serolugo/logic-lab/docs/pinout.md

# Pinout Information

Pinout reference files and Quartus constraint files will be added in future updates.

Planned additions:

- GPIO mapping
- Seven-segment display pins
- LED assignments
- Switch assignments
- PMOD connector mapping
- Example Quartus constraint files
