serolugo/logic-lab/docs/toolchain.md

# Toolchain

## FPGA Design Software

The Logic Lab boards were designed for use with Intel Quartus Prime Lite.

Supported FPGA families:

- Intel MAX V
- Intel MAX 10

## PCB Design

Hardware was designed using EasyEDA Pro.

## Manufacturing

Boards were manufactured using JLCPCB.
