serolugo/logic-lab/boards/logic-lab-max-v/Images/20260401_134947.jpg

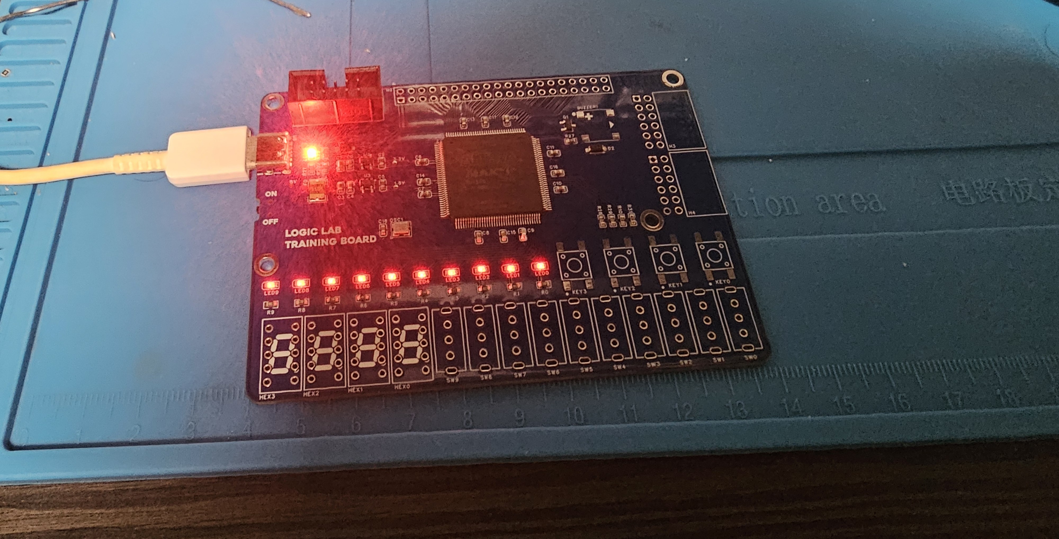
boards/logic-lab-max-v/Images/20260401_134947.jpg
