serolugo/logic-lab/boards/logic-lab-max-10/Schematic/logic-lab-max-10-schematic.pdf

# USB C EH

# POWER SWITCH

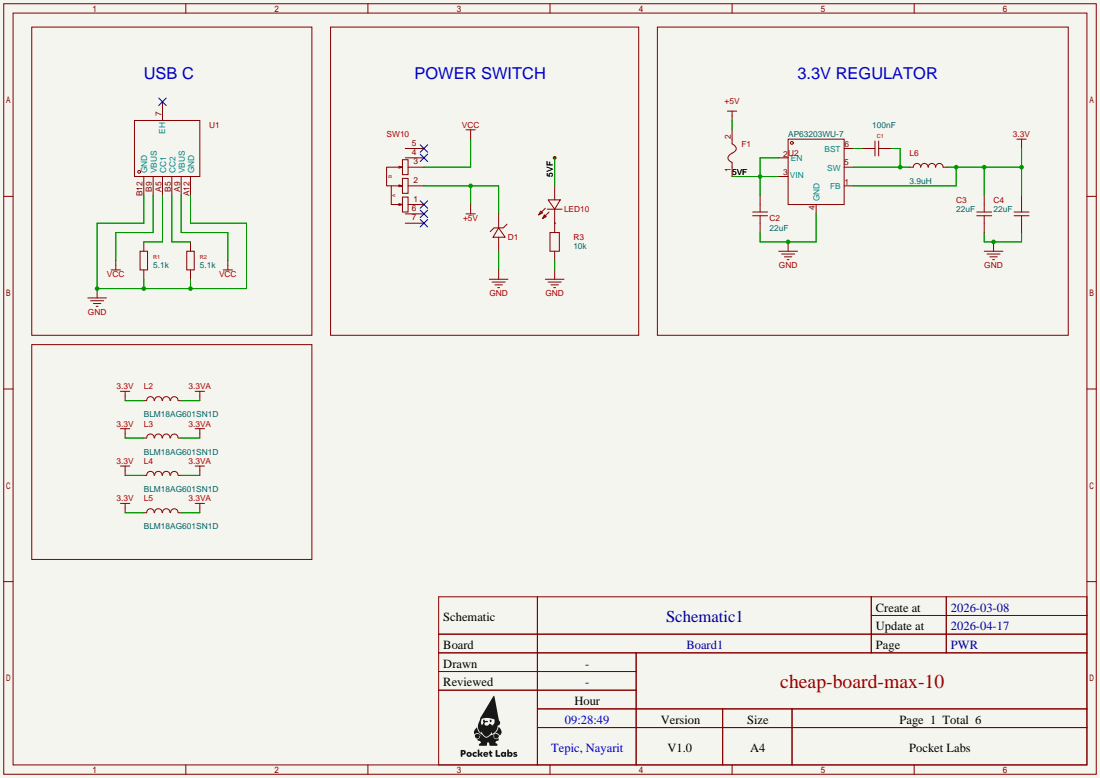
[picture p8: page 1]

Schematic | Schematic1 | Create at | 2026-03-08

Update at | 2026-04-17

Board | Board1 | Page | PWR
Drawn | - | cheap-board-max-10
Reviewed | -

Hour
09:28:49 | Version | Size | Page 1 Total 6

Tepic, Nayarit | V1.0 | A4 | Pocket Labs

# MAX 10 FPGA

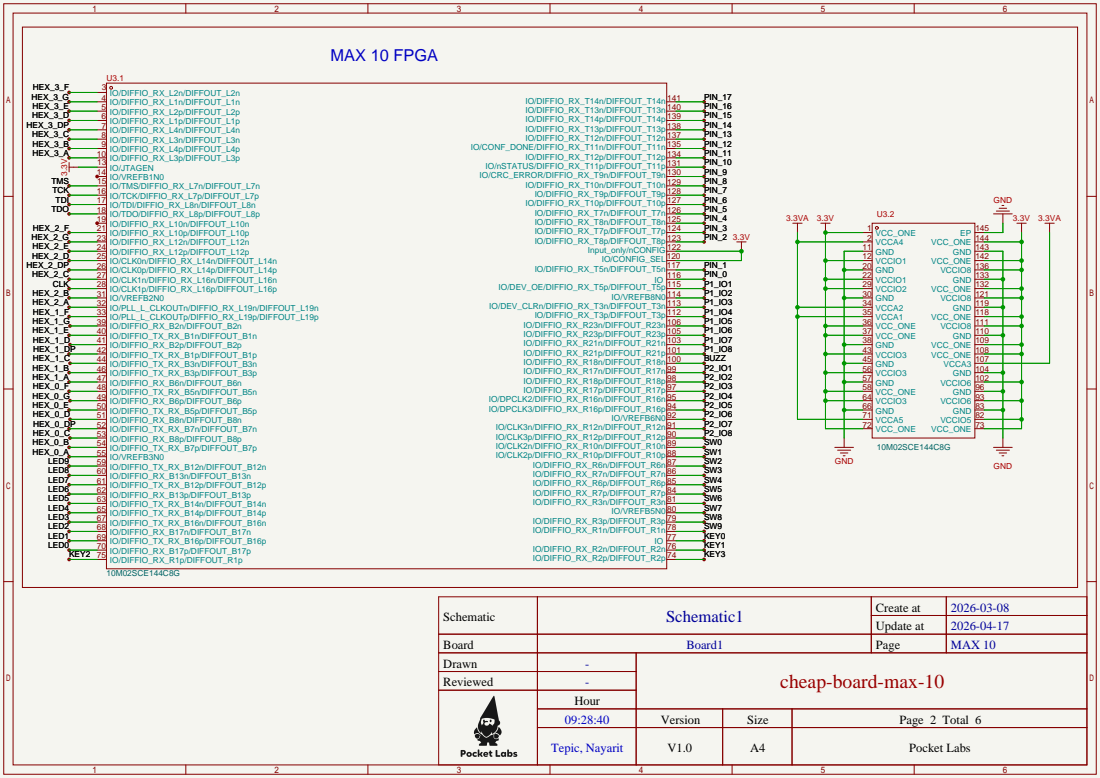
[picture p9: page 2]

Schematic | Schematic1 | Create at | 2026-03-08

Update at | 2026-04-17

Board | Board1 | Page | MAX 10
Drawn | - | cheap-board-max-10
Reviewed | -

Hour
09:28:40 | Version | Size | Page 2 Total 6

# DECOUPLING

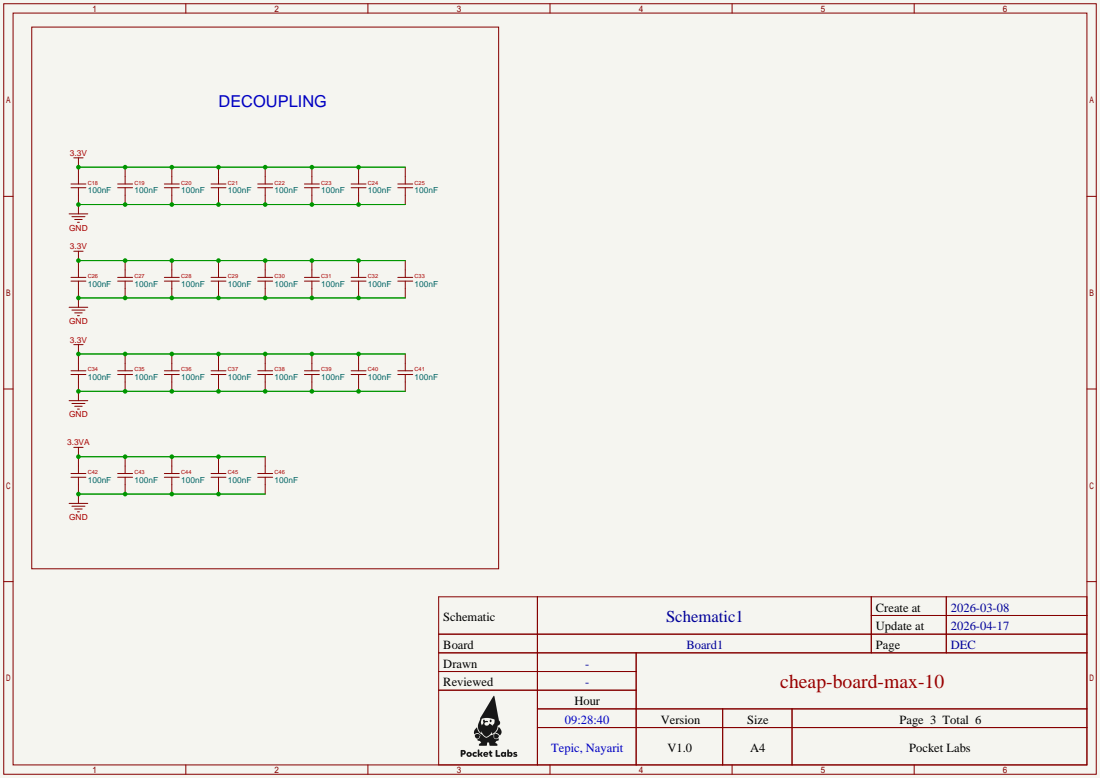
[picture p10: page 3]

Schematic | Schematic1 | Create at | 2026-03-08

Update at | 2026-04-17

Board | Board1 | Page | DEC
Drawn | - | cheap-board-max-10
Reviewed | -

Hour
09:28:40 | Version | Size | Page 3 Total 6

# SWITCH

# BUTTONs

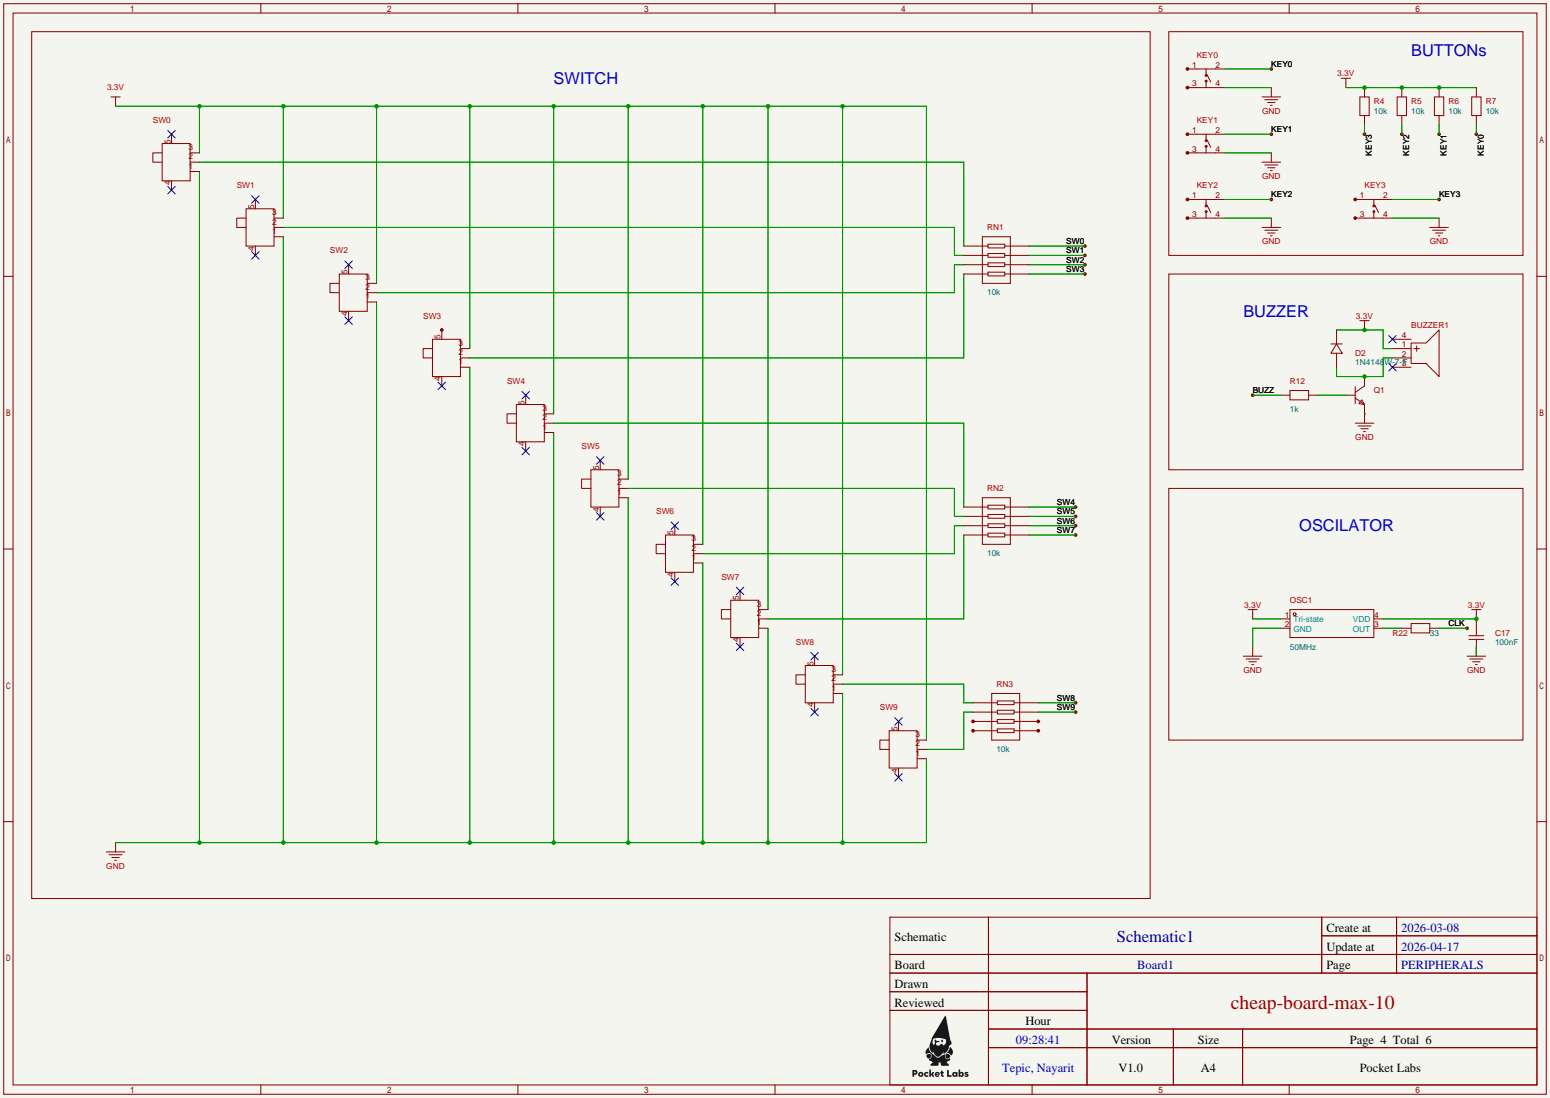
[picture p11: page 4]

Schematic | Schematic1 | Create at | 2026-03-08

Update at | 2026-04-17

Board | Board1 | Page | PERIPHERALS
Drawn | | cheap-board-max-10
Reviewed

Hour
09:28:41 | Version | Size | Page 4 Total 6

# 7 SEG DISPLAY

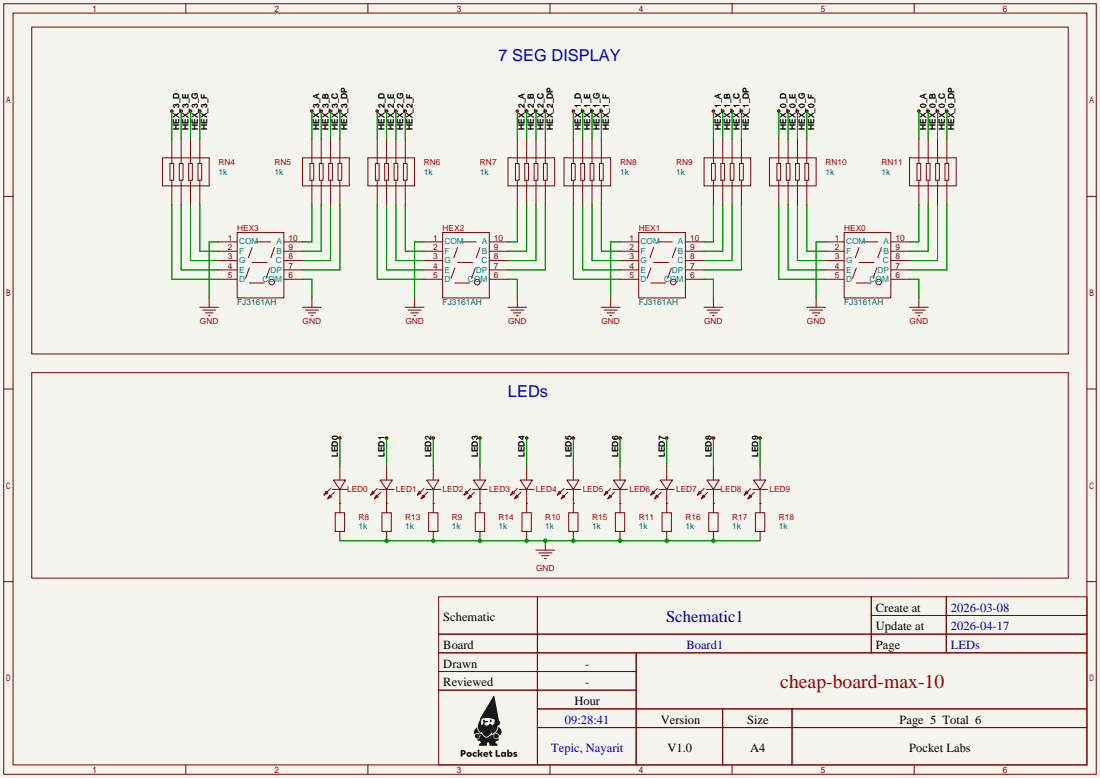
[picture p12: page 5]

Schematic | Schematic1 | Create at | 2026-03-08

Update at | 2026-04-17

Board | Board1 | Page | LEDs
Drawn | - | cheap-board-max-10
Reviewed | -

Hour
09:28:41 | Version | Size | Page 5 Total 6

40 40 39 39 | 38 38 37 37 | 36 36 35 35 | 34 34 33 33 | 32 32 31 31 | 30 30 29 29 | 28 28 27 27 | 26 26 25 25 | 24 24 23 23 | 22 22 21 21 | 20 20 19 19 | 18 18 17 17 | 16 16 15 15 | 14 14 13 13 | 12 12 11 11 | 10 10 9

# JTAG

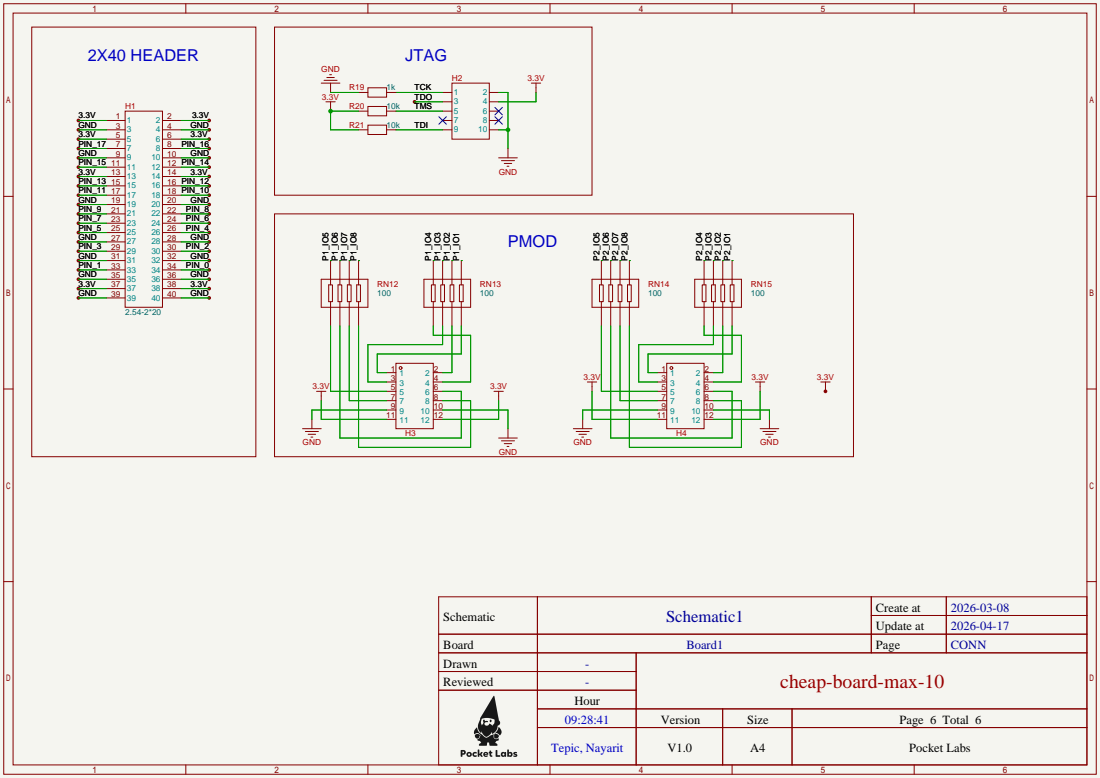
[picture p13: page 6]

Schematic | Schematic1 | Create at | 2026-03-08

Update at | 2026-04-17

Board | Board1 | Page | CONN
Drawn | - | cheap-board-max-10
Reviewed | -

Hour
09:28:41 | Version | Size | Page 6 Total 6
