serolugo/logic-lab/boards/logic-lab-max-v/Schematic/logic-lab-max-v-schematic.pdf

# USB C EH MAX V CPLD

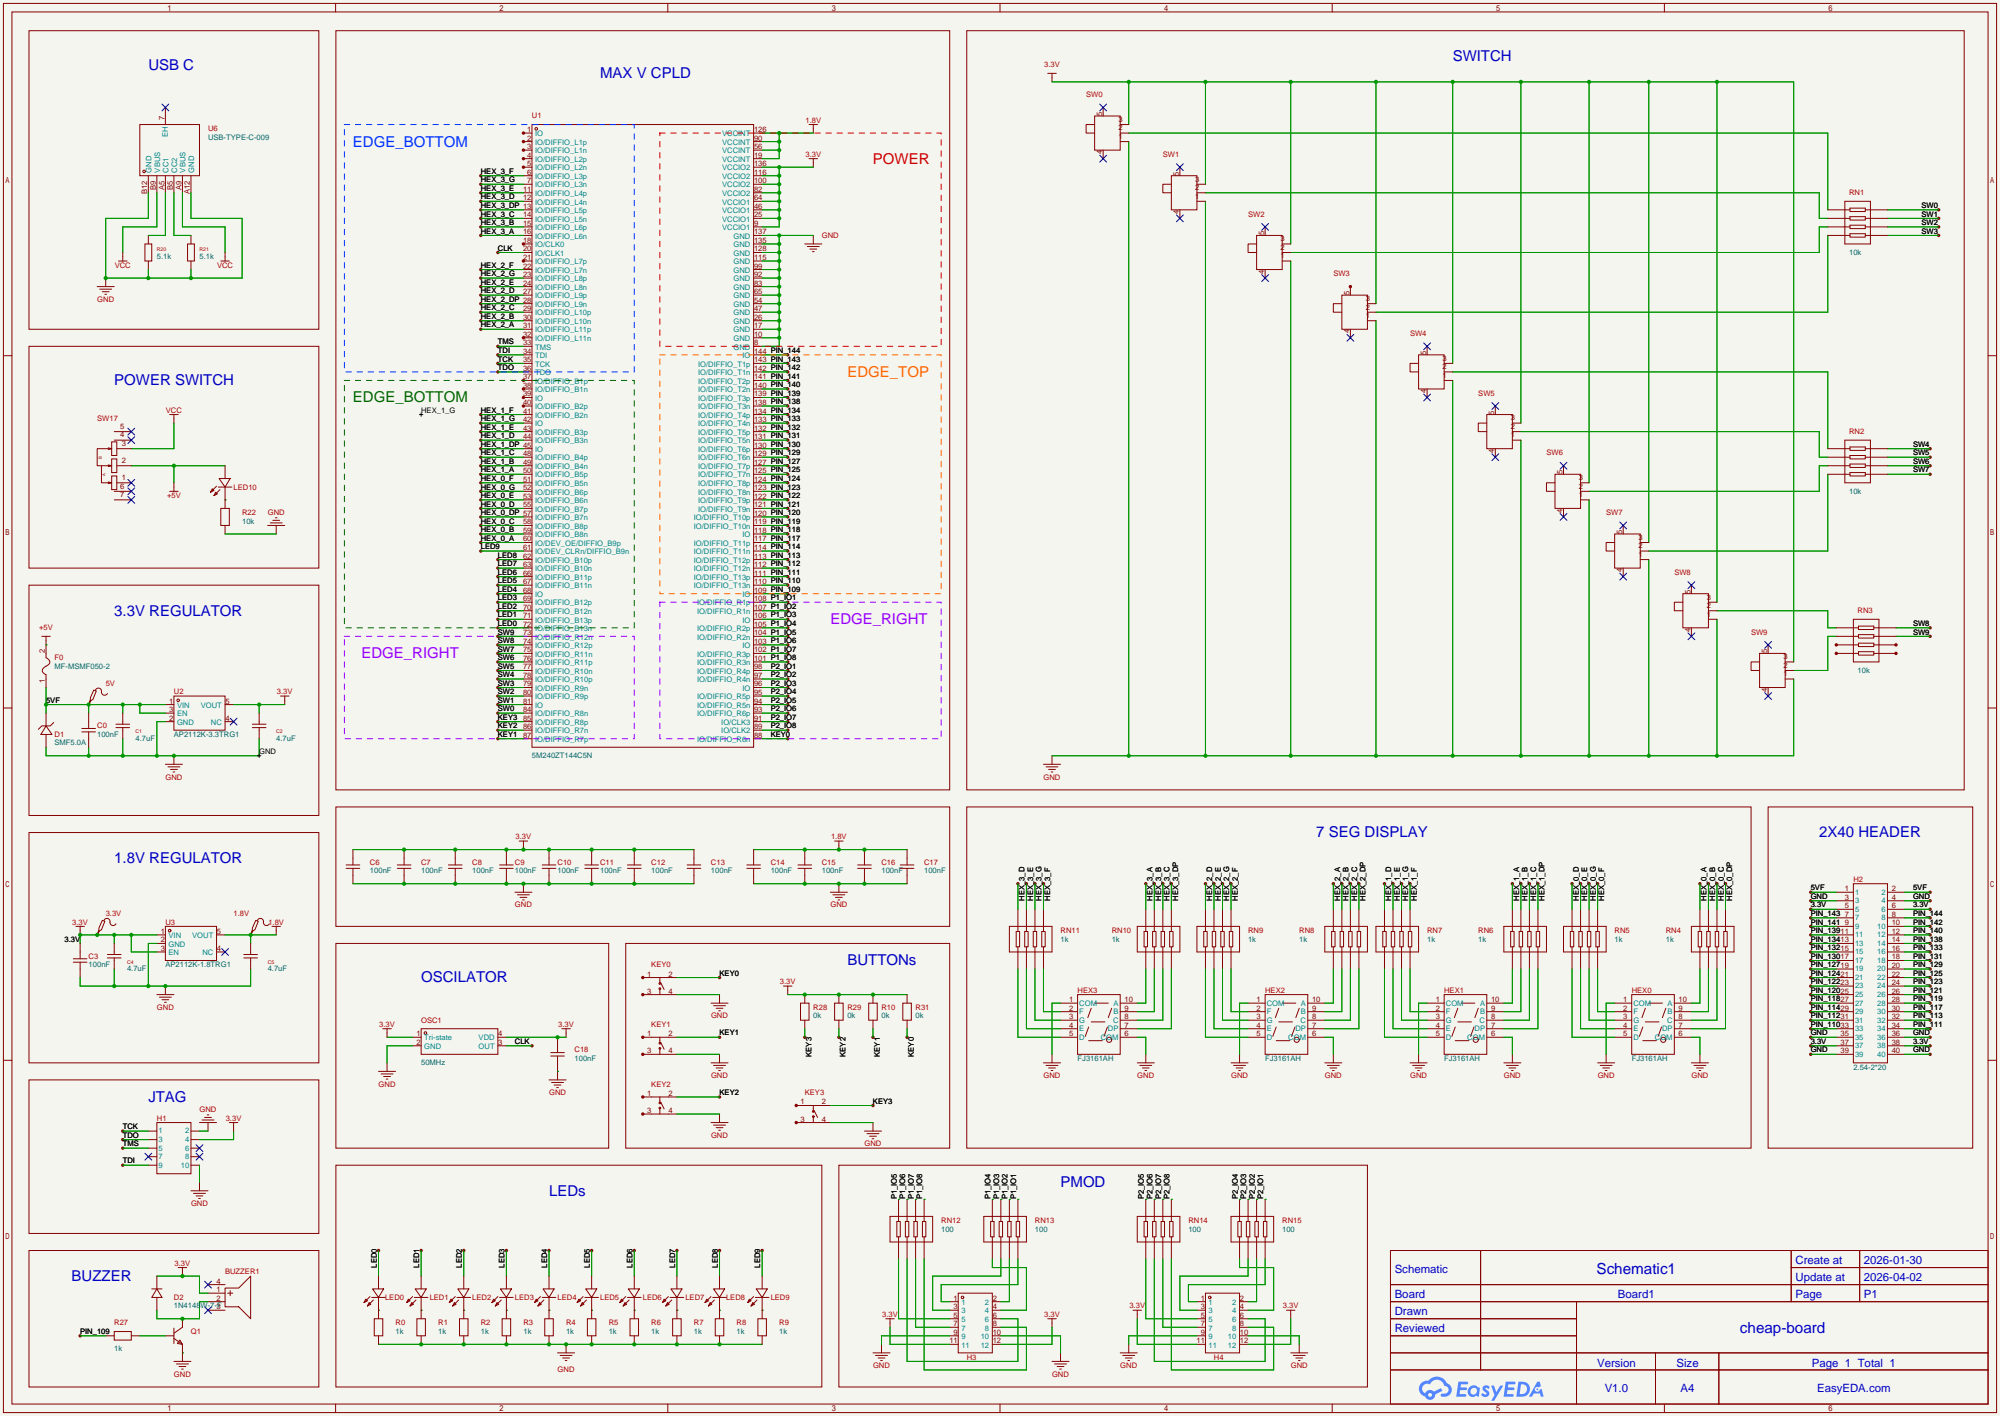
[picture p14: page 1]

VCCIO1 25 VCCIO1 46 VCCIO1 64 VCCIO2 82 VCCIO2 100 VCCIO2 116 VCCIO2 136 VCCINT 19 VCCINT 56 VCCINT 90 VCCINT 126

GND 10 GND 17 GND 26 GND 47 GND 54 GND 65 GND 83 GND 92 GND 99 GND 115 GND 128 GND 135 GND 137 VCCIO1 9

Schematic | Schematic1 | Create at | 2026-01-30

Update at | 2026-04-02

Version | Size | Page 1 Total 1
V1.0 | A4 | EasyEDA.com
