serolugo/logic-lab/(list of files, drawings)

Other design files:
boards/logic-lab-max-10/Hardware/ProPrj_cheap-board-max-10_2026-05-07.epro
boards/logic-lab-max-v/Hardware/ProPrj_cheap-board_2026-05-07.epro
